iotmakervn/iot-gprs-wifi-uno/iot-gprs-wifi-uno.kicad_pcb

## KiCad design iot-gprs-wifi-uno.kicad_pcb (2017-01-09)

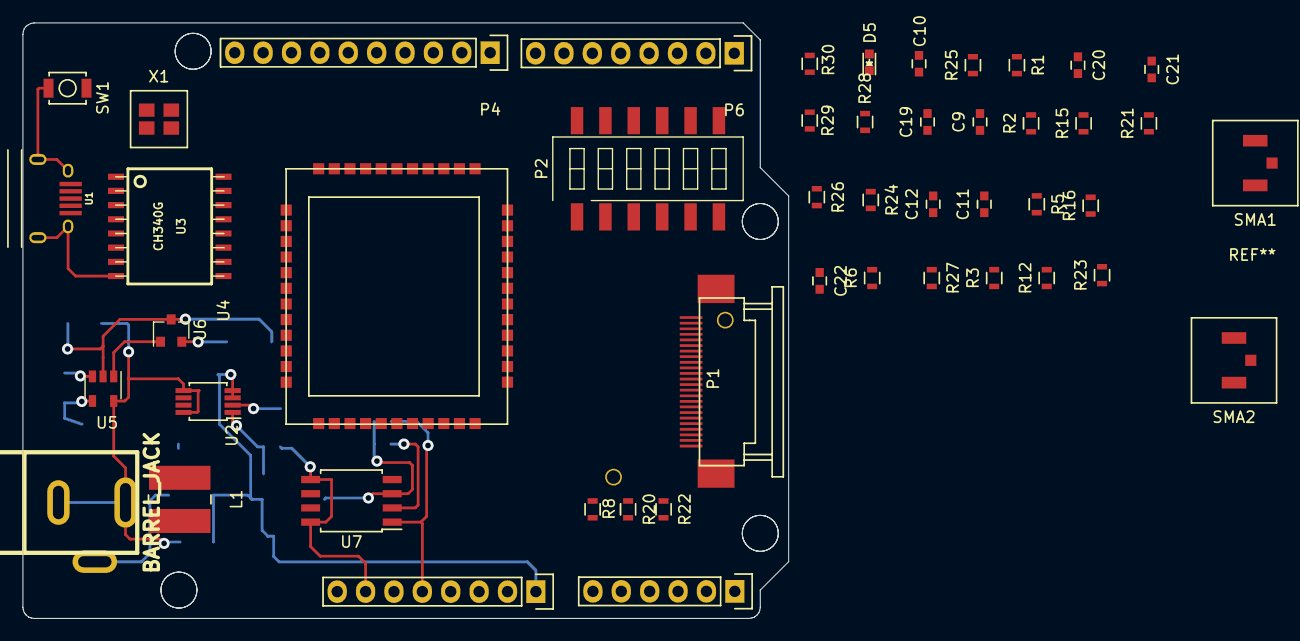
[picture p1: board iot-gprs-wifi-uno.kicad_pcb from above]

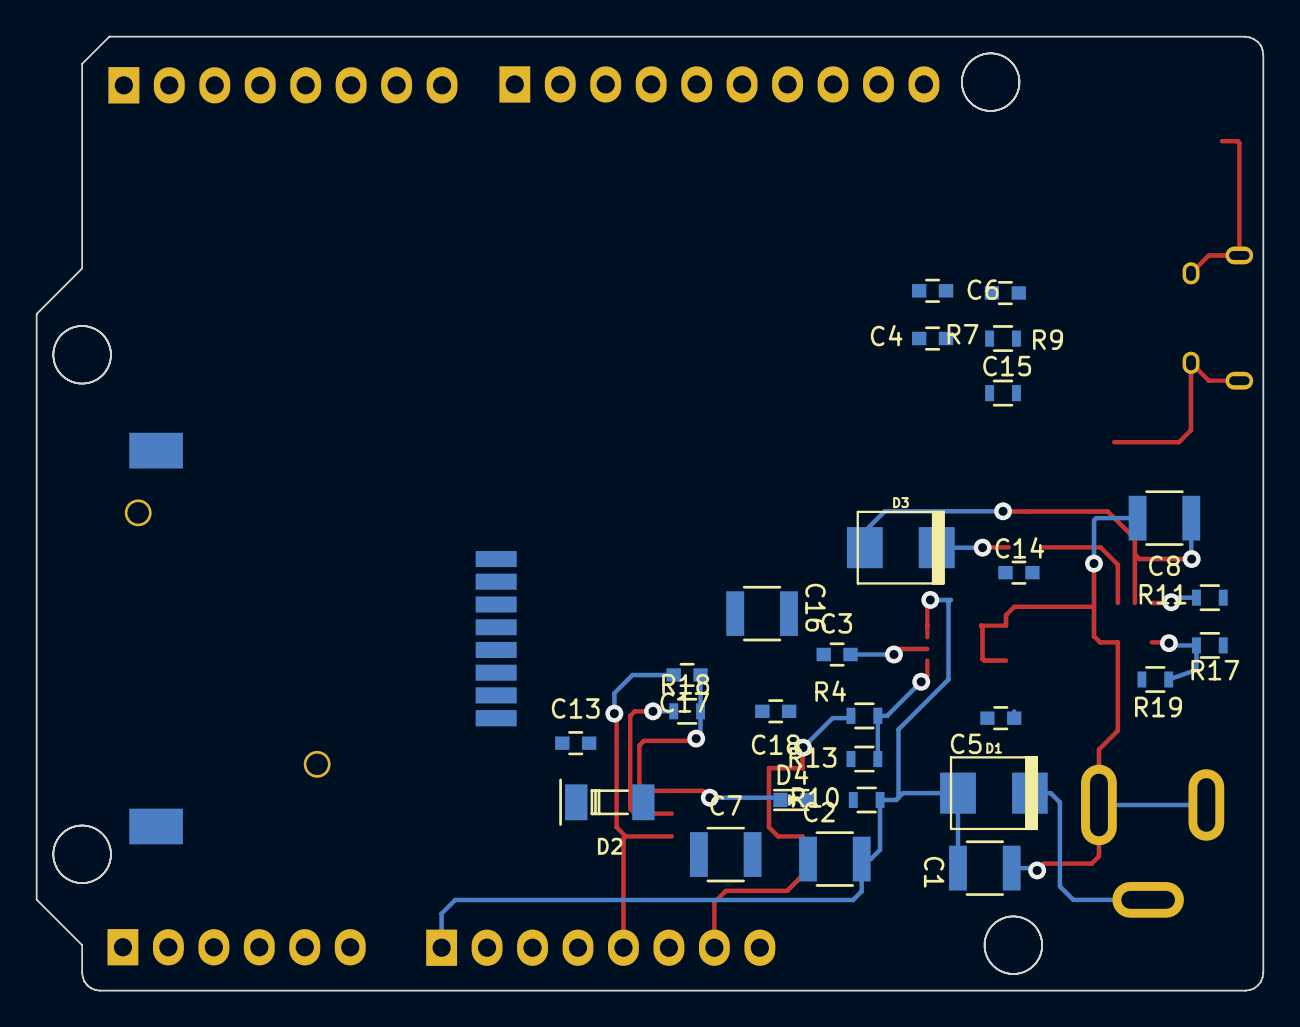
[picture p2: board iot-gprs-wifi-uno.kicad_pcb from below]

Board: 2 copper layers, 68.5 x 53.3 mm, 77 parts (29 on the bottom side), 73 nets.

Parts:
Arduino_Header: Val**; arduino_header
C1: 10uF/50V; C_1210
C2: 10uF/50v; C_1210
C3: 1uF; C_0603
C4, C6, C15: 22pF; C_0603
C5, C10, C14, C22: 100nF; C_0603
C7, C8: 10uF/25V; C_1210
C9: 22uF; C_0603
C11: 100pF; C_0603
C12: 470uF; C_0603
C13: 10uF; C_0603
C16: 1uF/25V; C_1210
C17: 1uF/25V; C_0603
C18, C19, C20, C21: 0.1uF; C_0603
CON1: BARREL_JACK; dc_socket
D1, D3: SS24; do214aa
D2: D_Zener; SOD-80
D4: L_PWR; LED_0603
D5: LED_blue; LED_0603
L1: 22uH; Choke_SMD_Wuerth-WE-PD2-Typ-MS
P1: CAMERASOCKET; camera_socket24aaa
P2: SW2x6; SW_DIP_x6_W8.61mm_Slide_SMD_LowProfile
P3, P6: CONN_01X08; Socket_Strip_Straight_1x08
P4: CONN_01X10; Socket_Strip_Straight_1x10
P5: CONN_01X06; Socket_Strip_Straight_1x06
R1, R3, R12, R16: NC; R_0603
R2, R15: 0K; R_0603
R4: 52.5K; R_0603
R5, R24, R25, R26, R27: 10K; R_0603
R6: 100R; R_0603
R7, R9, R28, R30: 470R; R_0603
R8: 10R; R_0603
R10, R11, R13: 10k; R_0603
R17: 3K/1%; R_0603
R18, R20, R21, R22, R23: 1K/1%; R_0603
R19: 470K; R_0603
R29: OR; R_0603
SMA1, SMA2: SMA; ANTEN_FP
SW1: SW_PUSH; SW_SPST_B3U-1000P
U1: usb_mini_b; USB_Micro-B
U2: MCP16311-MNY; MSOP-8_3x3mm_Pitch0.65mm
U3: CH340G; soic-16
U4: A20Module; a20module
U5: MCP6001R; SOT-23-5
U6: IRLM6402; SOT-23
U7: BD00GA5WEFJ; SOIJ-8_5.3x5.3mm_Pitch1.27mm
U8: SIM; SIM_HOLD_115A-ADA0-R02
X1: CRYSTAL_ABM3C; Crystal_SMD_3225_12MHz

Connections:
CAM_CLK: P1.13, U4.12
CAM_HREF: P1.9, U4.13
CAM_PCLK: P1.17, U4.11
CAM_PDN: P1.8, U4.41
CAM_RST: P1.6, U4.43
CAM_VSYNC: P1.7, U4.9
CAM_Y0: P1.19, U4.10
CAM_Y1: P1.21, U4.1
CAM_Y2: P1.22, U4.2
CAM_Y3: P1.20, U4.3
CAM_Y4: P1.18, U4.4
CAM_Y5: P1.16, U4.5
CAM_Y6: P1.14, U4.6
CAM_Y7: P1.12, U4.7
D+: U1.3, U3.5
D-: U1.2, U3.6
HST_RXD: P6.6, U4.37
I2C_SCL: R23.2, U4.31
I2C_SDA: R21.2, U4.30
unnamed: C3.1, U2.2
unnamed: C4.1, X1.1
unnamed: C5.1, U2.7
unnamed: C5.2, L1.1, U2.6
unnamed: C10.1, U3.4
unnamed: C16.1, C17.1, D4.1, R18.2, U7.3
unnamed: C22.1, R26.2
unnamed: CON1.1, D1.2
unnamed: D4.2, R19.2
unnamed: D5.1, R29.2
unnamed: D5.2, R28.1
unnamed: P1.3, R21.1
unnamed: P1.5, R23.1
unnamed: P1.23, R20.1
unnamed: P1.24, R22.1
unnamed: R1.1, R2.2, U4.21
unnamed: R2.1, R3.2, SMA1.3
unnamed: R5.1, U4.18
unnamed: R7.1, U3.2
unnamed: R9.1, U3.3
unnamed: R10.2, R11.1, U5.3
unnamed: R12.2, R15.2, U4.39
unnamed: R4.2, R13.1, U2.1
unnamed: R15.1, R16.2, SMA2.3
unnamed: R17.1, R18.1, U7.2
unnamed: R29.1, R30.1, SW1.1
unnamed: U5.1, U6.1
SIM_CLK: U4.15, U8.3
SIM_DATA: U4.17, U8.7
SIM_RST: U4.14, U8.2
SLEEP: R5.2, U4.35
UART_RXD: P2.1, P2.2, R7.2, U4.33
UART_TXD: P2.3, P2.4, R9.2, U4.34
U_RXD: P2.12, P6.8
U_TXD: P2.10, P6.7
VCC3.3: C9.2, C11.2, C17.2, P3.5, R17.2, R19.1, R24.1, R25.1, R26.1, R28.2, U4.19, U5.4, U7.1
VCC3.9: C12.1, C13.1, D2.1, R8.1, R20.2, U4.8, U4.45, U4.46
VCC5.0: C7.1, C8.1, C14.2, C15.1, C16.2, D3.1, L1.2, P3.4, P3.7, R4.1, R8.2, U3.16, U5.2, U6.3, U7.5, U7.8
VCC_USB: D3.2, U1.1, U6.2
VDD_1V8: C20.2, P1.10, U4.32
VDD_2V8: C19.2, C21.2, P1.4, P1.11, U4.42
VSIM: C18.2, U4.16, U8.1, U8.6
Vin: C1.1, C2.1, D1.1, P3.1, R10.1, U2.3, U2.4
WIFI_IO0: P4.10, R24.2, U4.28
WIFI_IO2: P4.9, R25.2, U4.27
WIFI_IO4: P4.1, P5.1, U4.29
WIFI_IO12: P4.6, P5.2, U4.24
WIFI_IO13: P2.7, P2.9, P3.6, P4.7, P6.4, U4.25
WIFI_IO15: P2.8, P2.11, P4.8, P5.3, P6.3, R6.2, R27.1, U4.26
WIFI_RST: P4.2, P6.5, R30.2, U4.20
WIFI_RXD: P4.5, U4.23
WIFI_TXD: P4.4, U4.22
XI: C6.1, U3.7, X1.3
XO: C1.2, C2.2, C3.2, C4.2, C6.2, C7.2, C8.2, C9.1, C10.2, C11.1, C12.2, C13.2, C14.1, C15.2, C18.1, C19.1, C20.1, C21.1, C22.2, CON1.2, CON1.3, D2.2, P1.2, P1.15, P3.2, P3.3, P4.3, R1.2, R3.1, R6.1, R11.2, R12.1, R13.2, R16.1, R27.2, SMA1.1, SMA1.2, SMA2.1, SMA2.2, SW1.2, U1.5, U1.6, U2.5, U2.8, U3.1, U3.8, U4.44, U5.5, U8.5, X1.2, X1.4
