iotmakervn/iot-gprs-wifi-uno/(commit log)

2016-12-22 add library of project;add kicad file of project
    [iot-gprs-wifi-uno.kicad_pcb, iot-gprs-wifi-uno.sch]
2016-12-31 add a20_module schematic add A20_module PCB add library add footprint library
    [iot-gprs-wifi-uno.sch]
2017-01-03 update Pcb,schematic error
2017-01-04 add .gitignore file add fp-lib-table
    [iot-gprs-wifi-uno.kicad_pcb]
2017-01-07 update Kicad PCb iot-gprs-wifi-uno-hw
    [iot-gprs-wifi-uno.kicad_pcb, iot-gprs-wifi-uno.sch]
2017-01-09 update schematic iot-gprs-wifi-uno-hw add a20 pretty folder
    [iot-gprs-wifi-uno.kicad_pcb, iot-gprs-wifi-uno.sch]
